c0pperdragon/HDMI2SCART/doc/pics/pic2.jpg

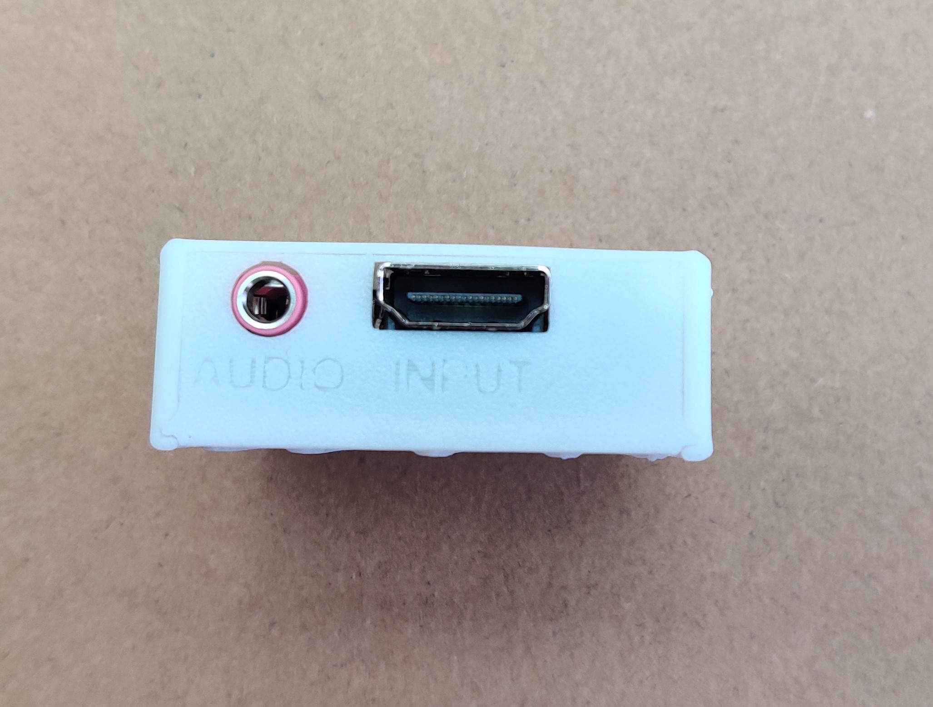
doc/pics/pic2.jpg
