c0pperdragon/HDMI2SCART/doc/pics/pic4.jpg

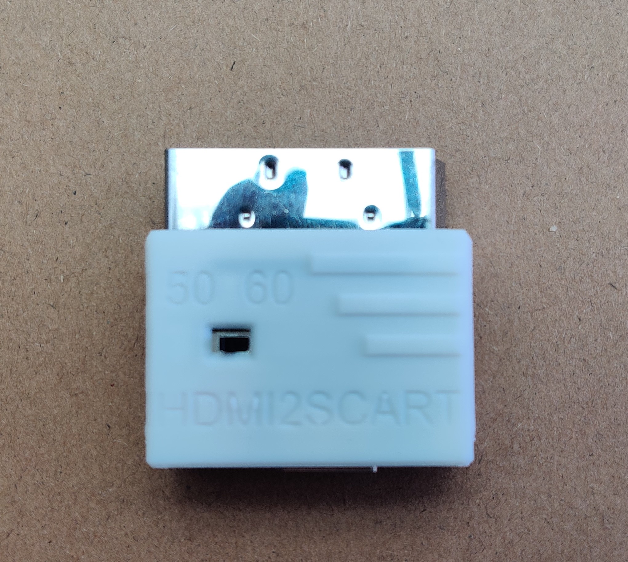
doc/pics/pic4.jpg
