c0pperdragon/HDMI2SCART/README.md

# HDMI2SCART
An adapter to drive a 15kHz analog monitor from a HDMI video source.
Its main purpose is to allow authentic look and feel for an emulator based
retro gaming solution. 
A second purpose is to interface with an RGBtoHDMI device for Lumacode decoding.
