c0pperdragon/HDMI2SCART/doc/pics/pic1.jpg

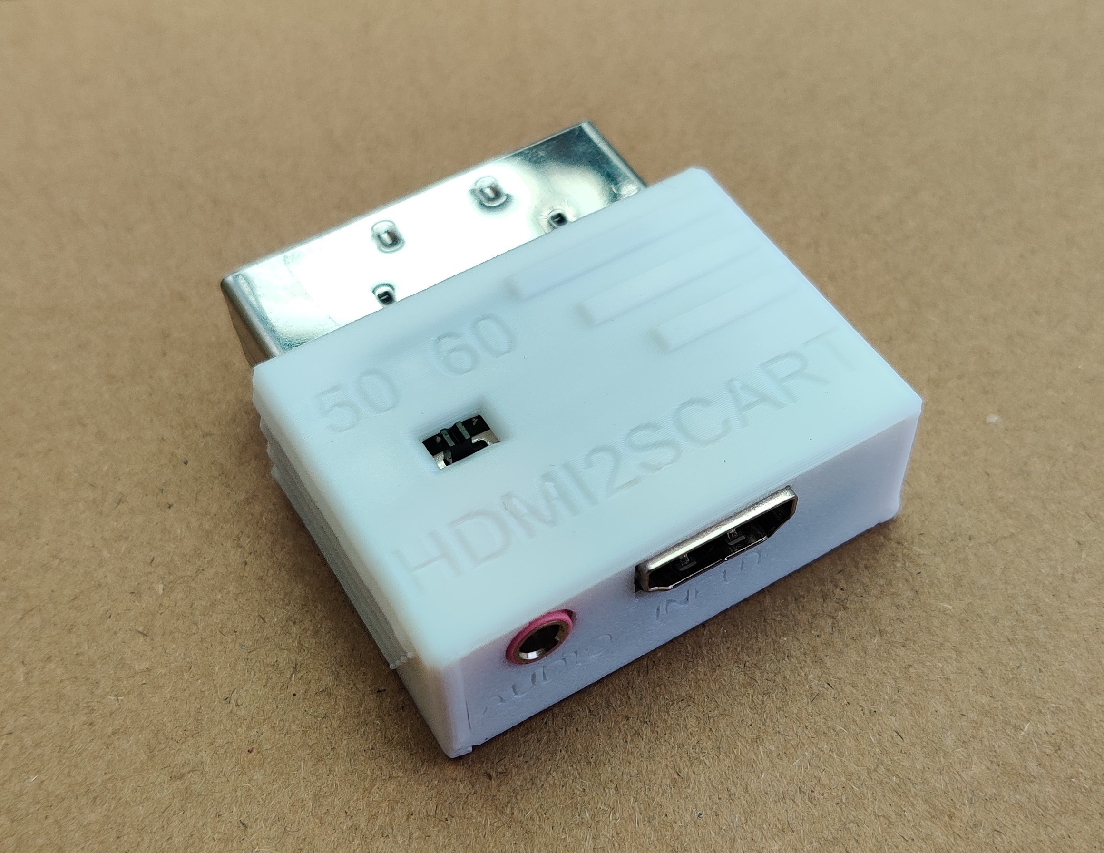
doc/pics/pic1.jpg
