c0pperdragon/HDMI2SCART/doc/pics/pic3.jpg

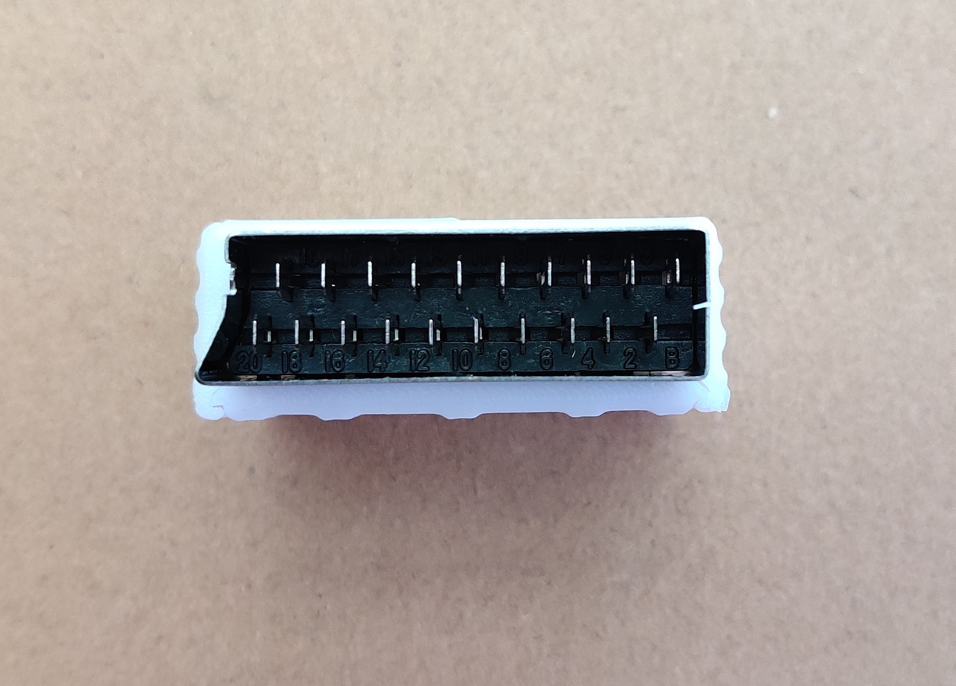
doc/pics/pic3.jpg
