c0pperdragon/HDMI2SCART/doc/pinout_NX3303X.webp

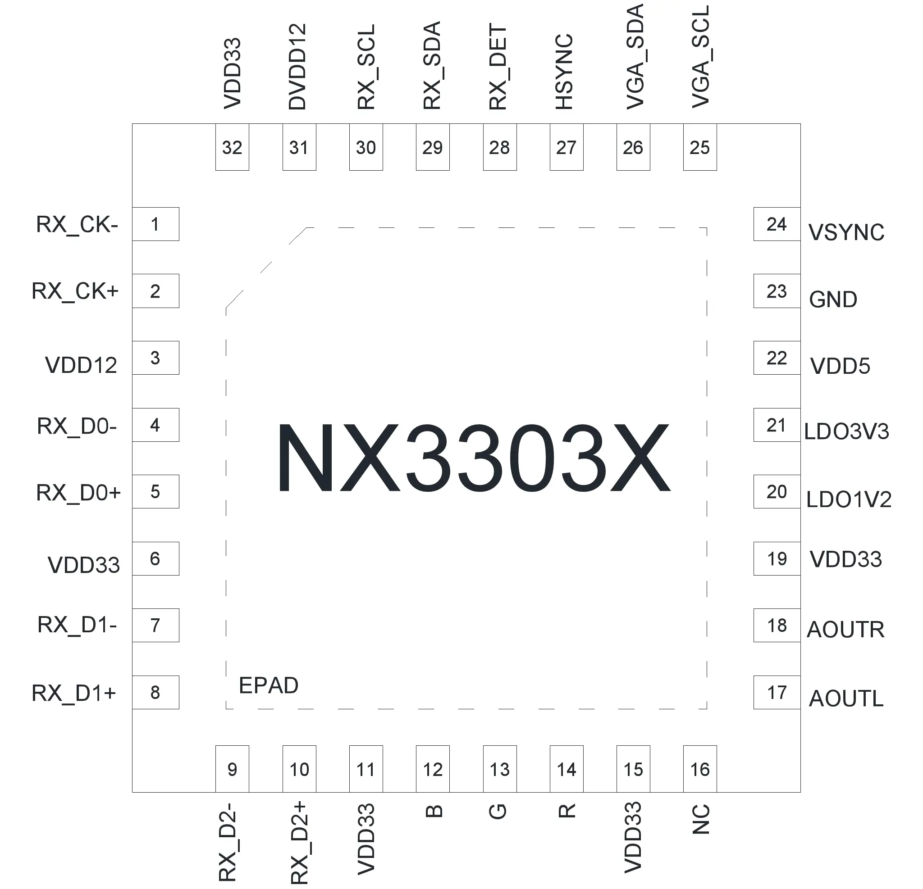
doc/pinout_NX3303X.webp
