c0pperdragon/HDMI2SCART/h2cboard_rev2/h2cboard.pdf

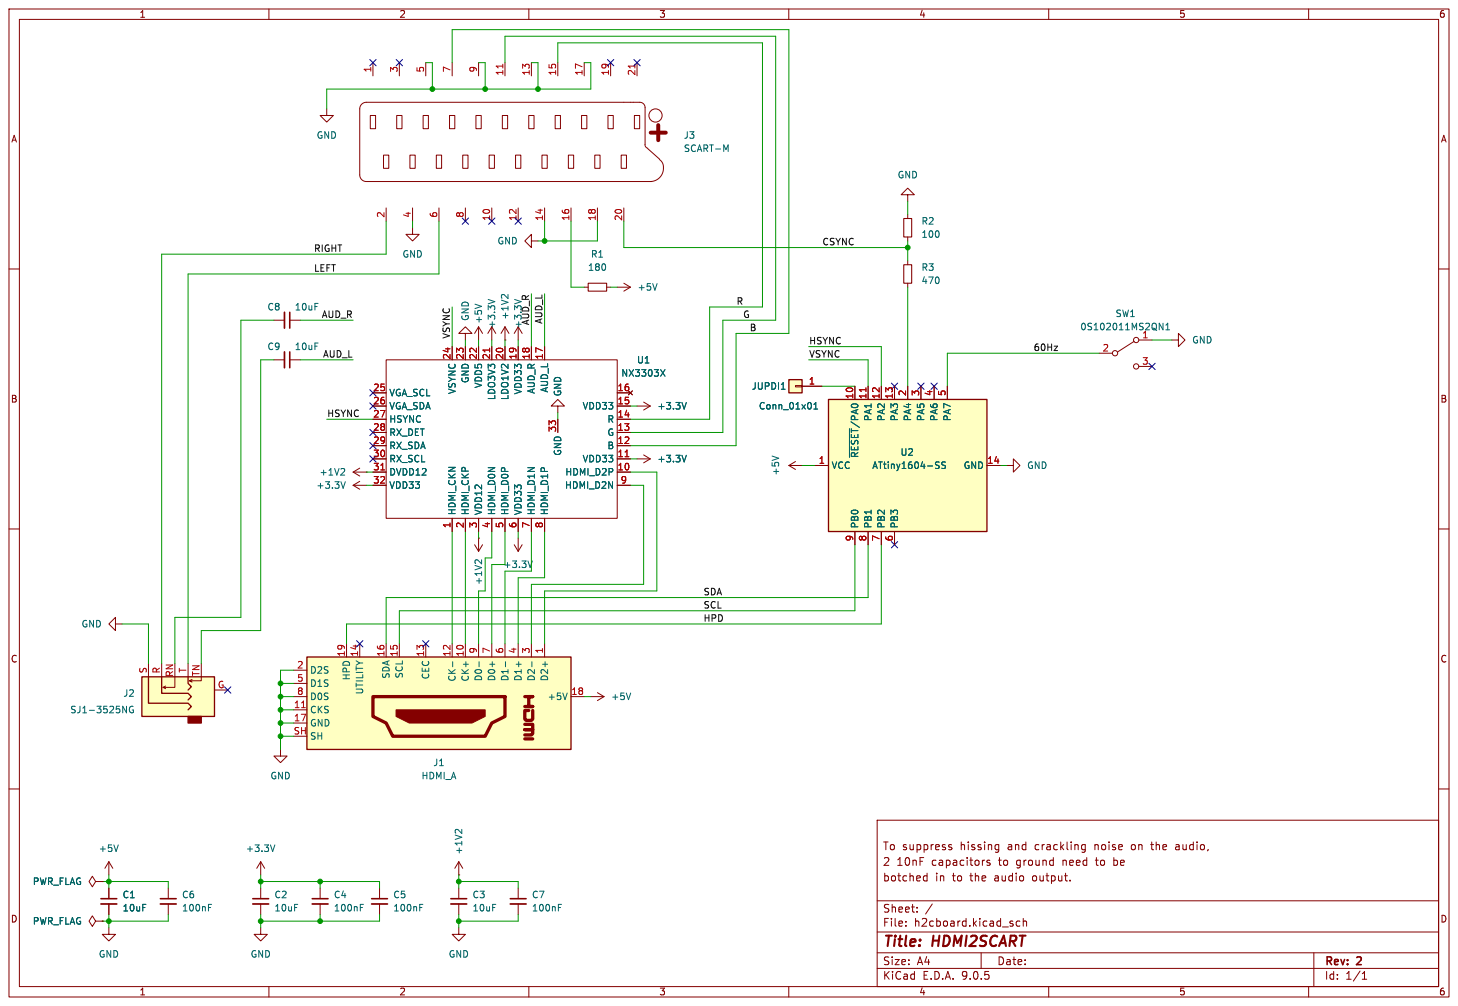
[picture p6: page 1]

7 D0- 9 CK+ 10 CK- 12 CEC 13 SCL 15 SDA 16 UTILITY 14 HPD 19 D2S 2 D1S 5 +5V 18 D0S 8 CKS 11 GND 17 SH SH
