c0pperdragon/HDMI2SCART/h2cboard_rev2/h2cboard.kicad_pcb

## KiCad design h2cboard_rev2/h2cboard.kicad_pcb (2025-02-24)

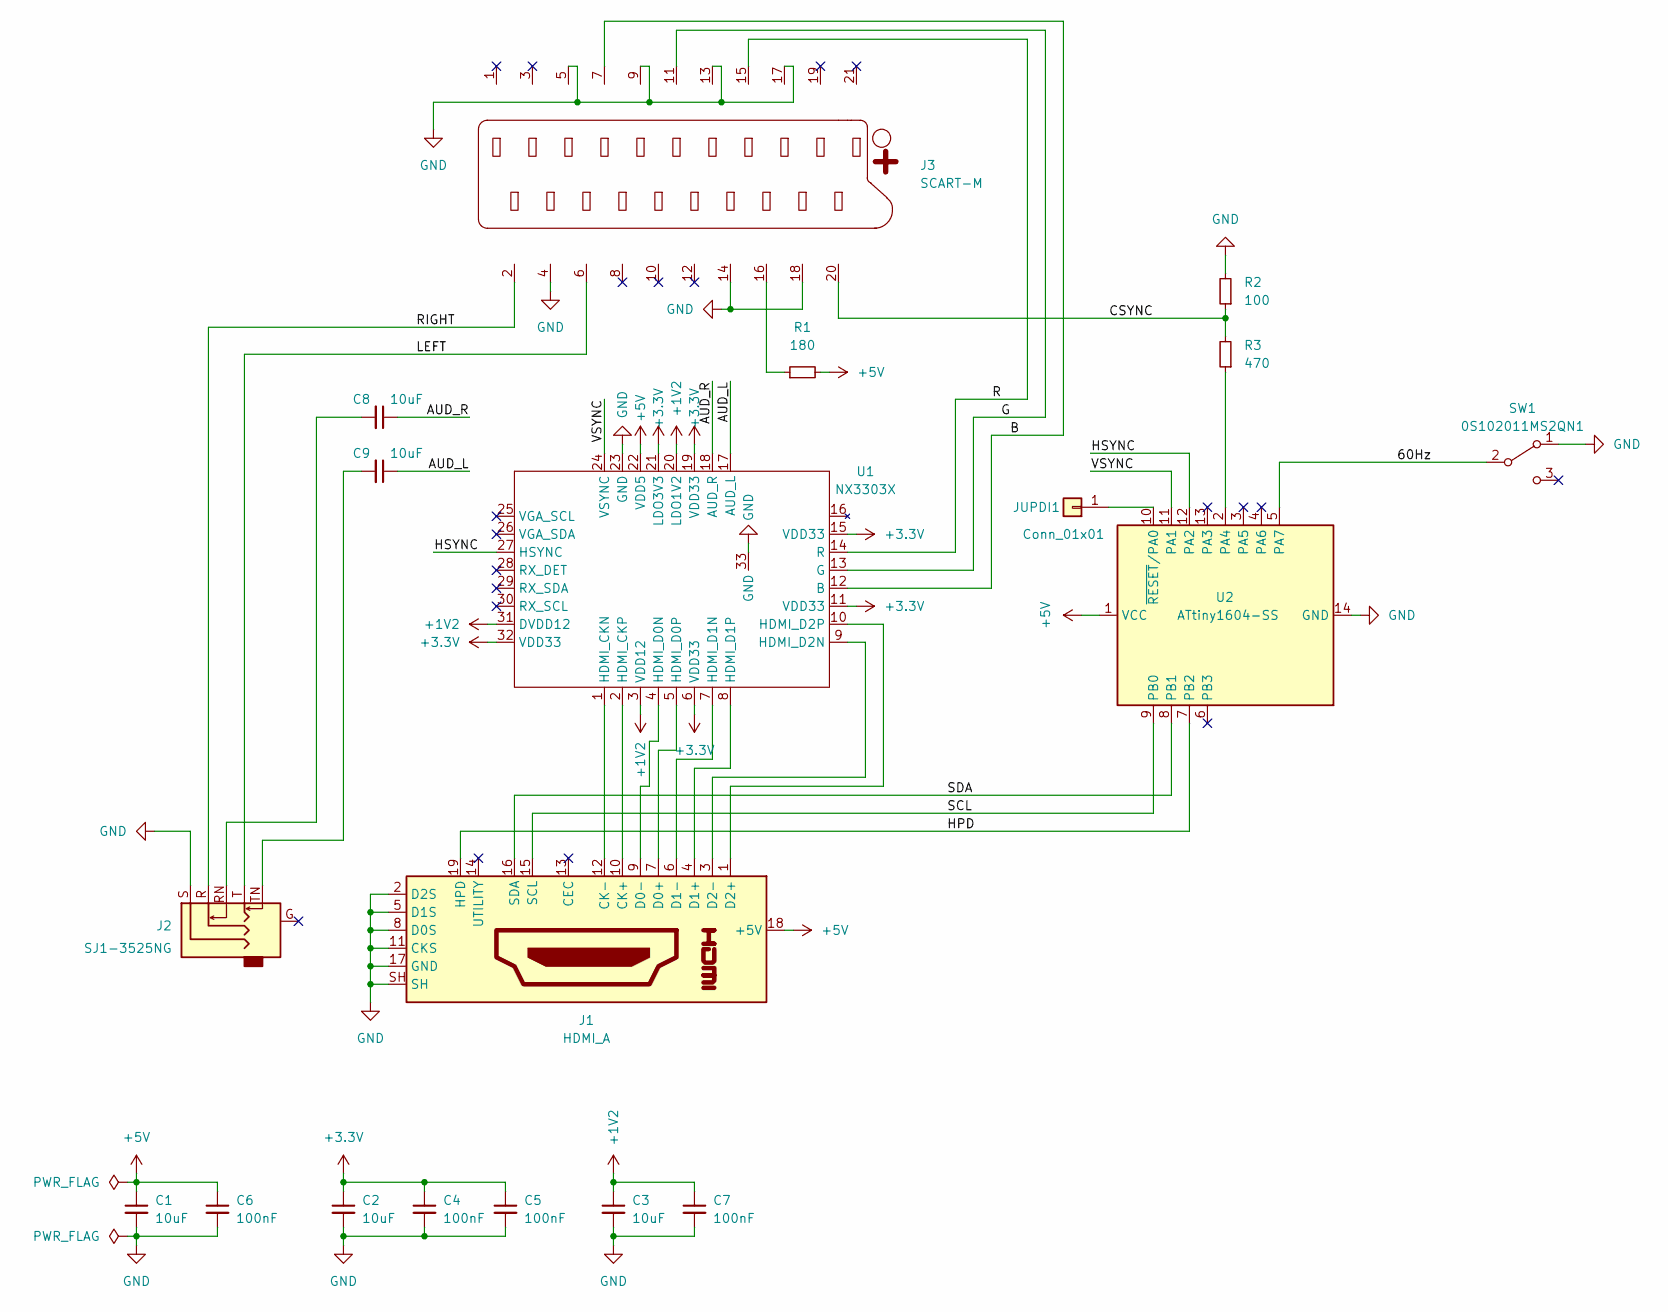
[picture p7: schematic h2cboard.kicad_sch, HDMI2SCART]

Parts:
C1, C2, C3, C8, C9: 10uF; C_0805_2012Metric
C4, C5, C6, C7: 100nF; C_0603_1608Metric
J1: HDMI_A; FCI_10029449-11-5B13-5DRLF
J2: SJ1-3525NG; audio_jack
J3: SCART-M; SCART_Edge_mount
JUPDI1: Conn_01x01; PinHeader_1x01_P2.54mm_Vertical
R1: 180; R_0805_2012Metric
R2: 100; R_0805_2012Metric
R3: 470; R_0805_2012Metric
SW1: 0S102011MS2QN1; SW_Slide_1P2T_CK_OS102011MS2Q
U1: NX3303X; QFN-32-1EP_5x5mm_P0.5mm_EP3.1x3.1mm_ThermalVias
U2: ATtiny1604-SS; SOIC-14_3.9x8.7mm_P1.27mm

Connections:
+1V2: C3.1, C7.1, U1.3 (VDD12), U1.20 (LDO1V2), U1.31 (DVDD12)
+3.3V: C2.1, C4.1, C5.1, U1.6 (VDD33), U1.11 (VDD33), U1.15 (VDD33), U1.19 (VDD33), U1.21 (LDO3V3), U1.32 (VDD33)
+5V: C1.1, C6.1, J1.18 (+5V), R1.2, U1.22 (VDD5), U2.1 (VCC)
/60Hz: SW1.2 (B), U2.5 (PA7)
/AUD_L: C9.1, U1.17 (AUD_L)
/AUD_R: C8.1, U1.18 (AUD_R)
/B: J3.7, U1.12 (B)
/CSYNC: J3.20, R2.1, R3.2
/G: J3.11, U1.13 (G)
/HPD: J1.19 (HPD), U2.7 (PB2)
/HSYNC: U1.27 (HSYNC), U2.12 (PA2)
/LEFT: J2.T, J3.6
/R: J3.15, U1.14 (R)
/RIGHT: J2.R, J3.2
/SCL: J1.15 (SCL), U2.9 (PB0)
/SDA: J1.16 (SDA), U2.8 (PB1)
/VSYNC: U1.24 (VSYNC), U2.11 (PA1)
GND: C1.2, C2.2, C3.2, C4.2, C5.2, C6.2, C7.2, J1.2 (D2S), J1.5 (D1S), J1.8 (D0S), J1.11 (CKS), J1.17 (GND), J1.SH, J2.S, J3.4, J3.5, J3.9, J3.13, J3.14, J3.17, J3.18, R2.2, SW1.1 (A), U1.23 (GND), U1.33 (GND), U2.14 (GND)
unnamed: C8.2, J2.RN
unnamed: C9.2, J2.TN
unnamed: J1.10 (CK+), U1.2 (HDMI_CKP)
unnamed: J1.12 (CK-), U1.1 (HDMI_CKN)
unnamed: J1.7 (D0+), U1.5 (HDMI_D0P)
unnamed: J1.9 (D0-), U1.4 (HDMI_D0N)
unnamed: J1.4 (D1+), U1.8 (HDMI_D1P)
unnamed: J1.6 (D1-), U1.7 (HDMI_D1N)
unnamed: J1.1 (D2+), U1.10 (HDMI_D2P)
unnamed: J1.3 (D2-), U1.9 (HDMI_D2N)
unnamed: J3.16, R1.1
unnamed: JUPDI1.1, U2.10 (~RESET/PA0)
unnamed: R3.1, U2.2 (PA4)

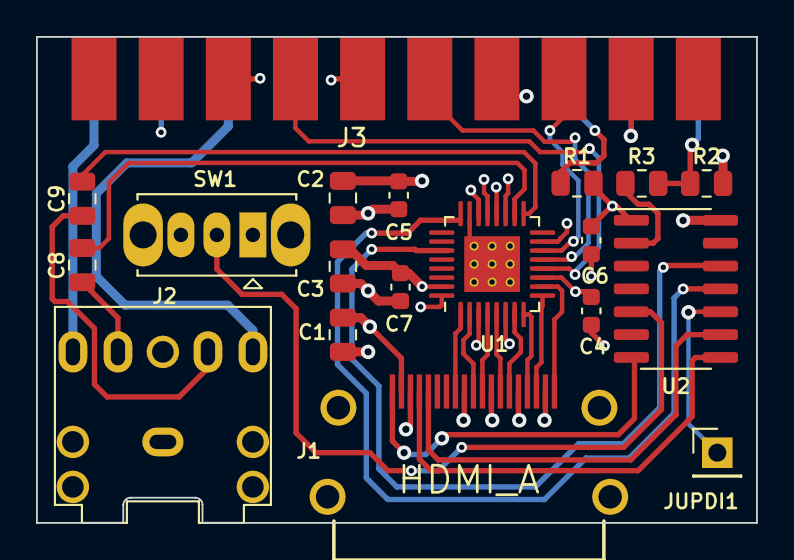
[picture p8: board h2cboard.kicad_pcb from above]

Board: 4 copper layers, 40.0 x 27.0 mm, 19 parts (1 on the bottom side), 31 nets.
