c0pperdragon/HDMI2SCART/(commit log)

2024-02-05 Make 1440x288 EDID compatible with RGBtoHDMI and Windows
    [computations.ods]
2024-02-09 Improve CSYNC generation
    [computations.ods]
2024-02-18 PCB design done
    [h2cboard.kicad_pcb, h2cboard.kicad_sch]
2024-02-19 Make gerbers
    [h2cboard.kicad_pcb]
2025-02-23 Second revision for different IC
    [h2cboard.kicad_pcb, h2cboard.kicad_sch]
2025-02-24 New PCB layout for rev.2
    [h2cboard.kicad_pcb, h2cboard.kicad_sch]
2026-05-18 Update DAC overview table. Add comment about noise-supression botch.
    [h2cboard.kicad_sch]
2026-05-30 Noise suppression filter of 10nF is already good enough, and should not filter too much high frequencies out of the audio.
    [h2cboard.kicad_sch]
